KOHSUK/lumberjack-keyboard/footprints/README.md

# Footprint sources and licenses

The following files were copied from [Salicylic-acid3/KiCAD_FootPrint](https://github.com/Salicylic-acid3/KiCAD_FootPrint):

| File in this directory | Source path in the local source checkout |
| --- | --- |
| `CherryMX_Hotswap_1u.kicad_mod` | `kbd_SW/CherryMX_Hotswap_1u.kicad_mod` |
| `CherryMX_Choc_Hotswap_1u.kicad_mod` | `kbd_SW/CherryMX_Choc_Hotswap_1u.kicad_mod` |

The local source checkout HEAD at verification was `d37028960ff8672ccb321f63a0f2cd2442e897fd`. Source paths above describe the local checkout; upstream directory names may differ. Verification date: 2026-10-10.

Both files are unmodified copies: their SHA-256 hashes matched the corresponding files in the local source checkout. This records the checkout revision observed during verification, rather than a separately recorded original import revision.

These two footprints are distributed under the MIT terms in the upstream `Licence.txt`. The complete upstream license text, including the copyright and permission notices for Salicylic_acid3, gachiham, and foostan, is preserved in [KiCAD_FootPrint-Licence.txt](../licenses/KiCAD_FootPrint-Licence.txt).

This notice applies to the two files listed above. It does not change the license of the project or establish the provenance of other footprints in this directory. Retain the accompanying license when redistributing these files, including modified versions.
